Recovid/Controller/design/DESIGN.md

# Overview of Controller v2 specifications

## Use cases

Le RECOVID ne peut être utilisé que conjointement à un Oxymètre médical qui mesure, surveille et alerte le taux d'oxygénation du patient. Le Contrôleur est responsable d'assurer le cycle respiratoire (Insuffler, Relâcher) à une fréquence de 12 à 35 fois par minute H24 jusqu'à 14j d'affilées et d'alerter sur le moindre écart. L'IHM est nécessaire pour que le soignant analyse et ajuste les paramètres de la respiration (ce qui est tout de même moins critique).

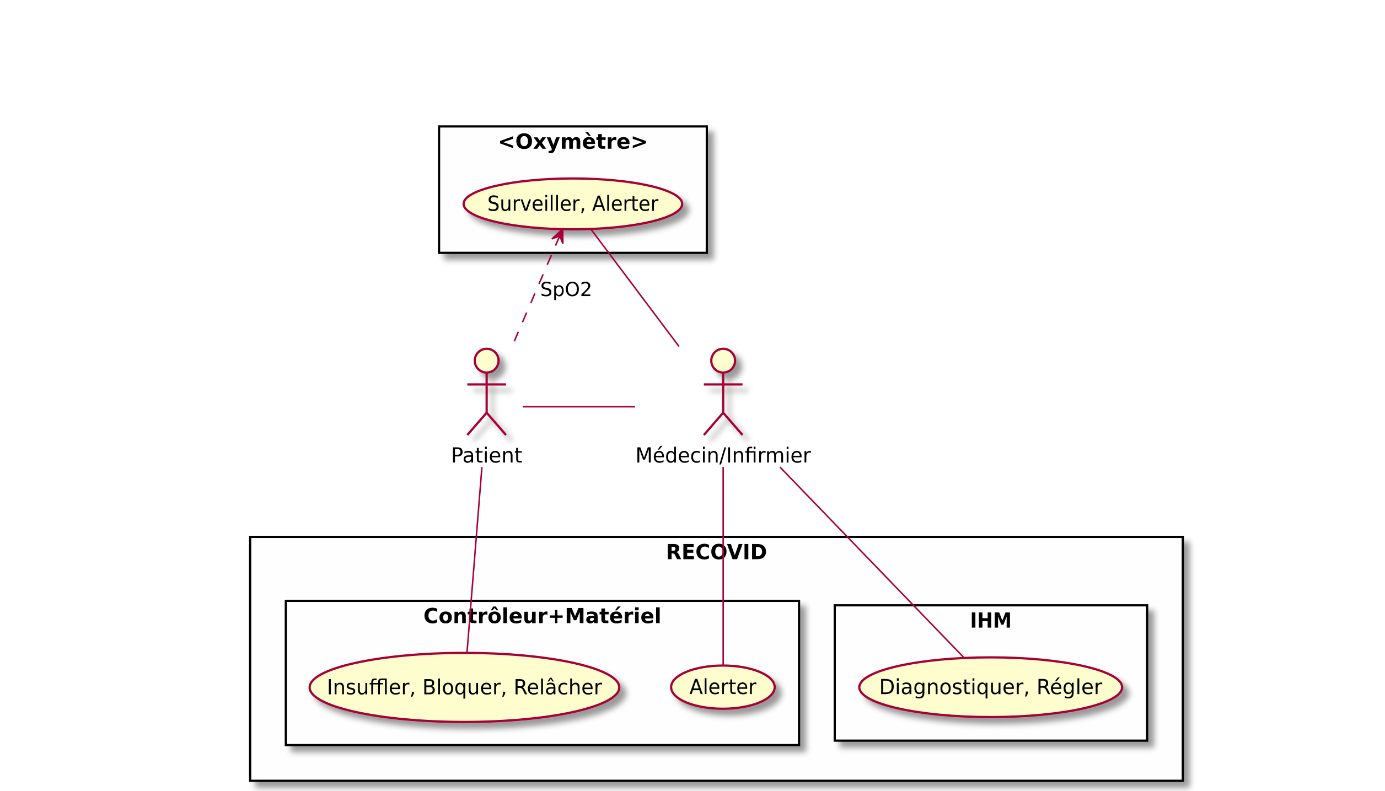
[picture p3: design/UseCases.png]


## Hardware

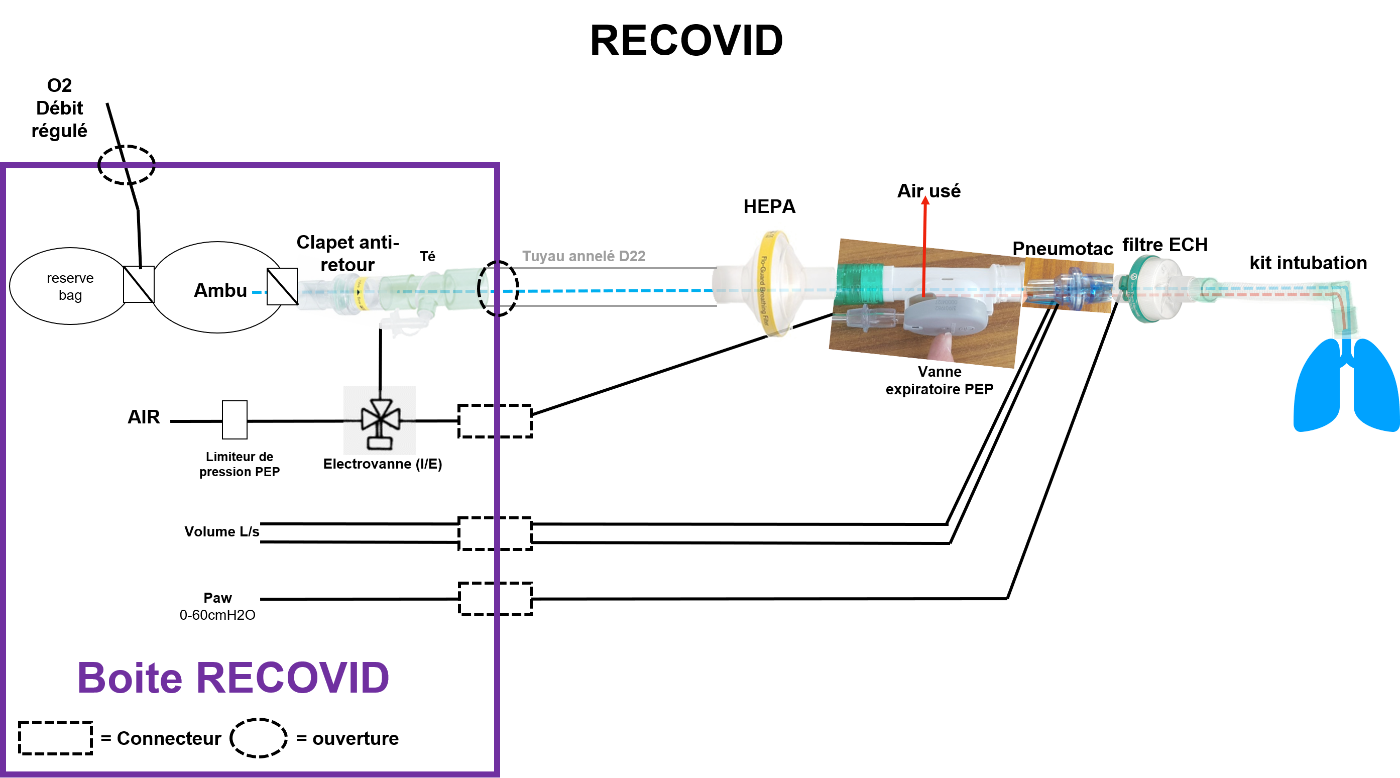
[picture p4: design/Schema_general_17avril.png]


## Information flow

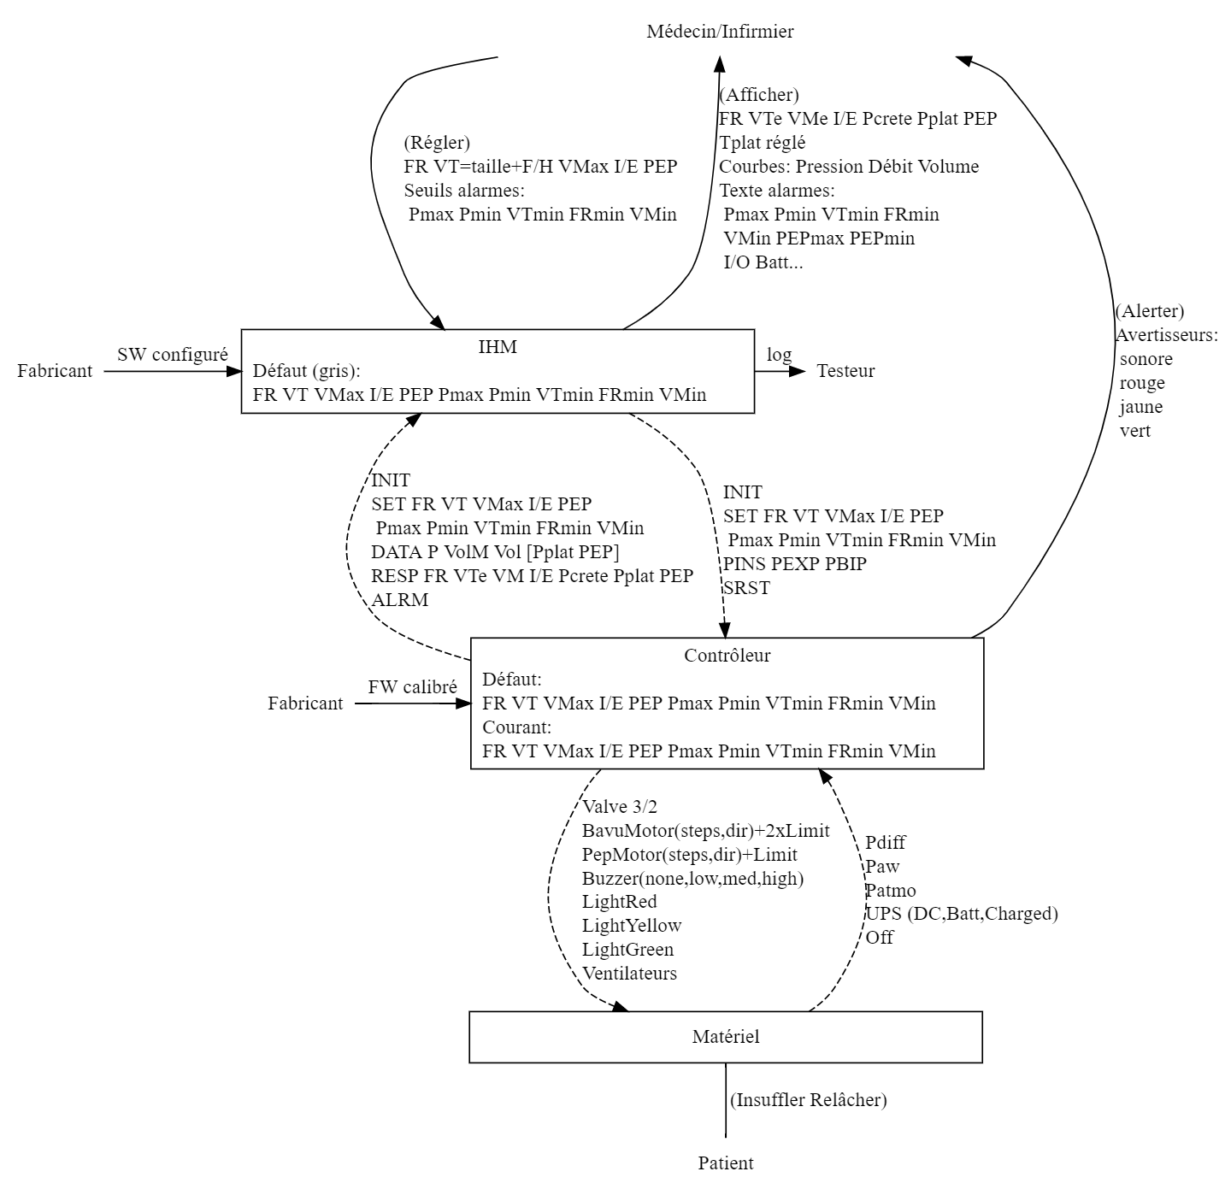
[picture p5: design/InformationFlow.png]


## State machines specifications

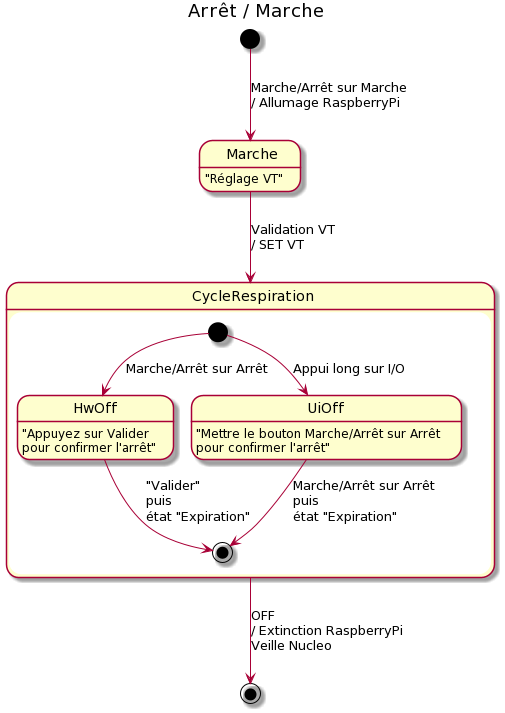
[picture p6: design/ArretMarche.png]


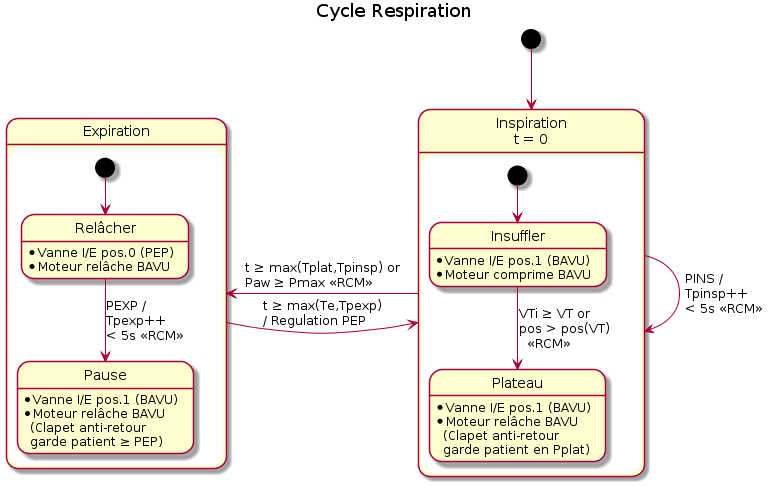
[picture p7: design/CycleRespiration+RCM.png]


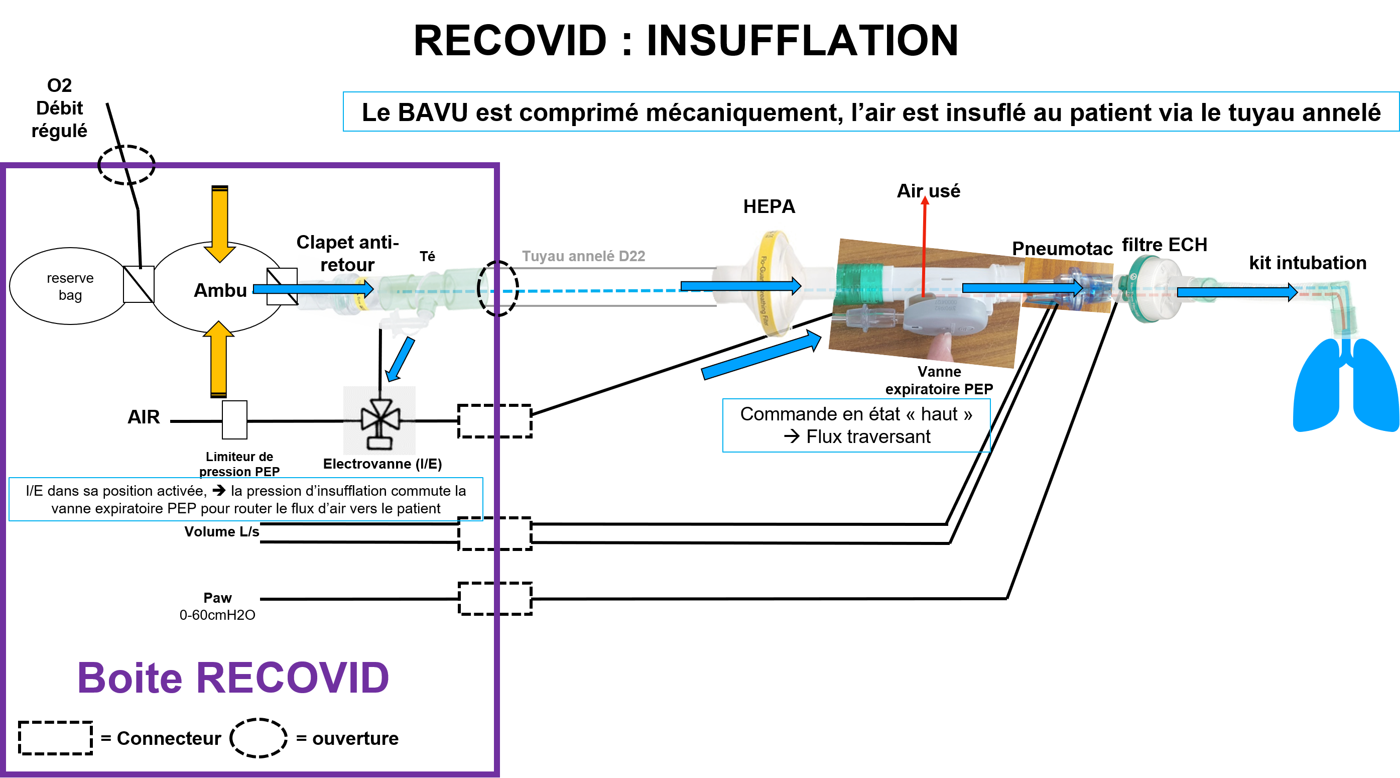
[picture p8: design/Schema_general_17avril_Insufflation.png]


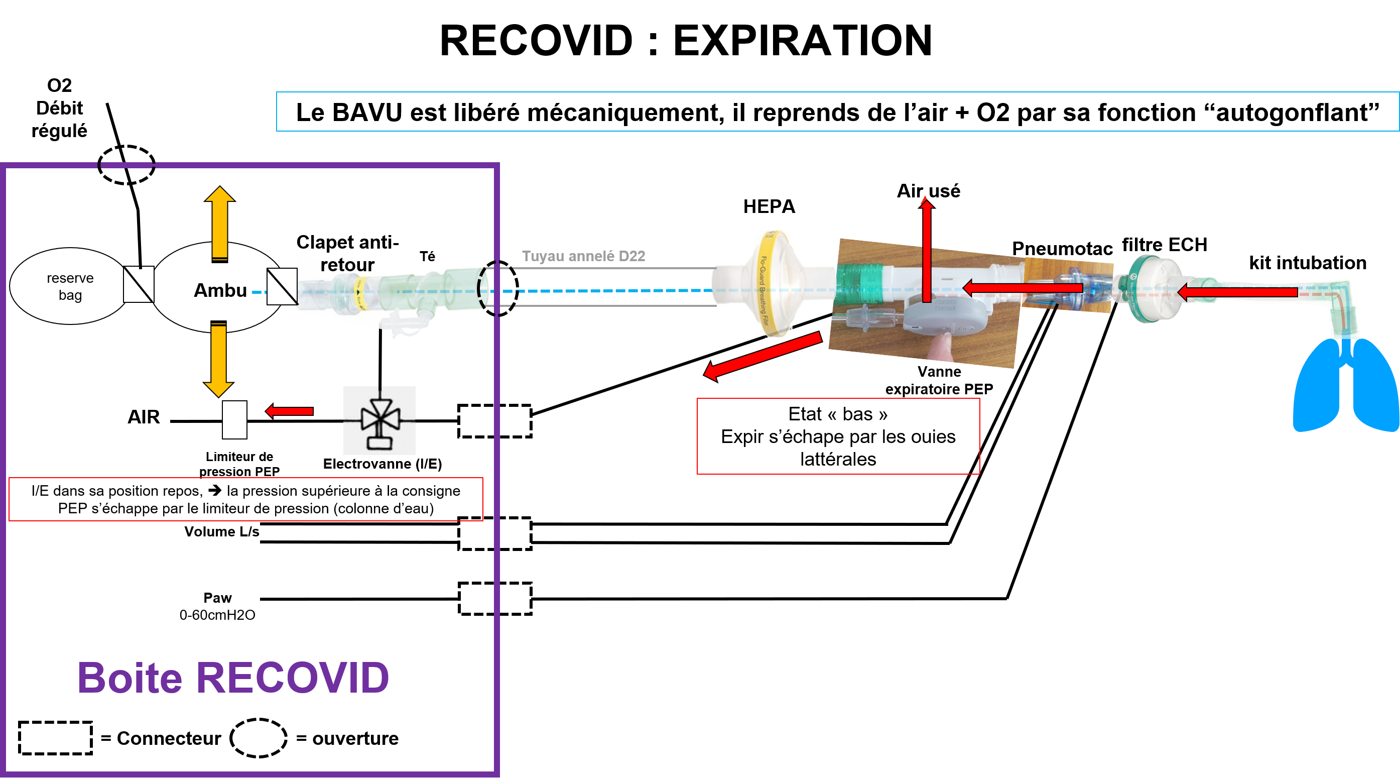
[picture p9: design/Schema_general_17avril_Expiration.png]


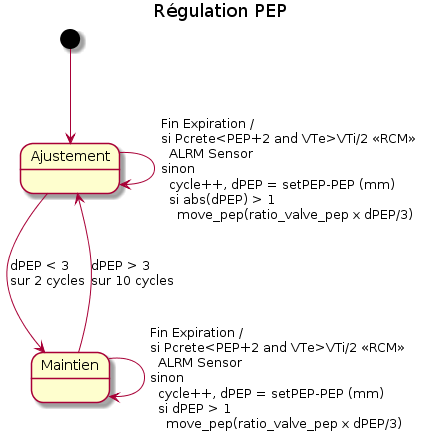
[picture p10: design/RegulationPEP.png]
