Recovid/Controller/(threads)

Thread 32 (2020-04-23):

Garantir un bon fonctionnement des conditions temporelles en cas de wrap-around

arnaud-clere, 2020-04-23:
Dans vos conditions temporelles de changement d'état (ou autres) il faut comparer des intervalles et non des temps absolus. Il faut aussi que vos temps soient comptés par des unsigned.
uint32_t t1=get_time_ms()
...
...
...
uint32_t t2=get_time_ms()

If ( t2 > t1 + zzz) peut retourner un résultat erroné s'il y a eu un rollover du timer

If ( t2-t1 > 800) retournera tjs un bon résultat (tant qu'il ny a pas eu 2 rollovers du timer)
Et comme la nucleo sera tjs alimentée (et pour le moment elle n'est pas mise en sommeil) , les risques de rollover ne sont pas à exclure

Thread 35 (2020-04-24):

Implémenter un mode arrêt à 2 confirmations (IHM + bouton physique)

arnaud-clere, 2020-04-24:
La state machine ci-dessous décrit le fonctionnement Marche/Arrêt qui encadre le CycleRespiration

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

Les événements et actions de cette state machine viennent soit de l'IHM soit du contrôleur.
Il faut faire évoluer l'IHM en utilisant le dialogue "Quitter" existant.
Il faut implémenter des fonctions sur le contrôleur pour :
* accepter une trame "OFF\tCS8:xx\n" de l'UI
* interroger la pin FS_ENABLED de la board revB (0 = bouton physique Marche/Arrêt sur Arrêt)
* couper l'alim du RaspberryPi
* mettre le Nucleo en low consumption (ThomasS va proposer qq chose)

arnaud-clere, 2020-04-27:
Voir branche on_off pour une ébauche (sans low_consumption ni extinction raspi ni reset settings)

Thread 36 (2020-04-24):

Implémenter une sauvegarde des paramètres de respiration sur mémoire Flash

arnaud-clere, 2020-04-24:
Il faut intégrer l'implémentation des deux fonctions déclarées dans https://github.com/Recovid/Controller/blob/c7a69c7313f047c11a9a81b572a026811d9f7104/C_Controller/lowlevel/include/lowlevel.h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
Dans le fichier :
https://github.com/Recovid/Controller/blob/master/C_Controller/lowlevel/stm32f303/flash.c

De sorte que le code de ihm_communication.c puisse lancer la sauvegarde *asynchrone* des paramètres validés. Cette fonction sera appelée en phase expiration pour ne pas perturber le driver moteur qui fonctionne en DMA.

Le fichier attaché implémente la fonction mais il faut encore l'intégrer.

De Hugo Van Reeth :
Le fichier à regarder est "Flash_save.c/h", dans lequel on trouve une fonction de Save et une fonction de Restore des paramètres. Il est plus simple d'écrire tous les paramètres d'un coup car il faut faire un erase de Flash avant écriture.

Quelques détails :
La structure de settings suivante n'existe pas dans le code (les paramètres individuels sont encapsulés dans ihm_communication.c) :
typedef struct __attribute__ ((aligned(4))){
    int version; // should always be first, since we use a pointer to this for union
    int setting_FR_pm;
    int setting_VT_mL;
    int setting_PEP_cmH2O;
    int setting_Vmax_Lpm;
    int setting_EoI_ratio;
    int setting_Pmax_cmH2O;
    int setting_Pmin_cmH2O;
    int setting_VTmin_mL;
    int setting_FRmin_pm;
    int setting_VMmin_Lm;
    int magic; // usefull to check that all settings were written until the end
    int crc; // should always be the last thing to write in Flash
} Settings_t;

J'ai donc rajouté par rapport aux settings de base
- en premier une Version
- à la fin un "magic" qui contient un int fixe qui permet de savoir au moins que tous les paramètres ont été écrit (double vérification avec le CRC qui peut tomber juste par hasard) (ca peut etre enlevé sur le CRC est robuste, ce qui n'est pas le cas dans mon exemple).
- puis un crc (j'ai fait un XOR de base, je ne sais pas ce que vous comptez utiliser comme type de CRC).
•	Les fonctions de lecture/écriture sont :
     int Save_Settings(Settings_t* settings, int pageAddress);
     int Restore_Settings(Settings_t* settings, int pageAddress);
Ces fonctions gèrent les erase de flash, les lecture/ecriture, et les calculs CRC. Il peut être intéressant de rajouter une vérification des valeurs des settings à postériori (si ils sont dans une fourchette cohérente, ...)
•	Pour les lectures/ecritures en Flash, plutot que de faire paramètre par paramètre, je copie directement le contenu mémoire de la structure complète en Flash sans me soucier du type de chaque setting. Avec cette mécanique, on peut rajouter/enlever des paramètres (de n'importe quel type int, float, char...) dans la structure sans avoir à retoucher les fonctions de lecture/ecriture Flash. C'est plus simple que d'écrire un par un les paramètres, qui pourraient avoir des types différents.
Par contre, il faut toujours que la version soit en premier dans la structure car je fais pointer mes pointeurs d'écriture dessus.
•	J'écris à la derniere page de la Flash (addresse 0x0807F800). J'ai modifié le .ld pour enlever cette page de la mémoire programme.
•	Le fichier main.c permet de tester ça :
-> Restore des paramètres au démarrage de la carte
-> Si appui court sur le bouton de la Nucleo => ecriture de données random dans la strcture, et sauvegarde en Flash
-> Si appui long (>1s) sur le bouton de la Nucleo => ecriture de valeurs par défaut dans la strcture, et sauvegarde en Flash

arnaud-clere, 2020-04-24:
[TEMPLATE_F303.zip](https://github.com/Recovid/Controller/files/4530333/TEMPLATE_F303.zip)

JulienDevillers, 2020-04-26:
Pour info, je ne crois pas que l'écriture en flash, influe sur le DMA. L'écriture en flash fige l'accès à la flash et donc empêche le code de continuer de s'exécuter (s'il est en flash, ce qui est généralement le cas) tant que l'écriture n'est pas terminée.

Sur le L0, L1, cela n'influe pas sur le DMA (voir AN4808 chapitre 2.2 _" Processes
independent from the core, such as DMA or peripherals may continue to work as long as
they avoid accessing the NVM bank."_ ).
Je pense que c'est pareil sur le F3. La sheet ne parle pas de stall du DMA pendant les fonctions de flash.

Si jamais ça aide.

Thread 37 (2020-04-24):

Simplifier la planification des différentes tâches pour plus de fiabilité ??!

arnaud-clere, 2020-04-24:
On a regroupé beaucoup de tâches FreeRTOS et il n'en reste que deux :
- La tâche "highlevel" qui gère le cycle respiratoire (1kHz)
- Une tâche qui gère la réception des messages de l'IHM
Cette dernière pourrait être appelée par cycle_respiration si et seulement si elle peut garantir de ne pas bloquer

A cette condition seulement, on pourrait n'avoir qu'une tâche high-level et une gestion du matériel par interrupt (I2C), moteur ballon (BAVU) via DMA+PWM, UART via DMA

Dans ce cas, on pourrait simplifier l'architecture en se passant de FreeRTOS pour, peut-être ??!, plus de maîtrise du code...

Closed 2020-04-28.

Thread 38 (2020-04-25):

Rendre la phase de relâchement du ballon (BAVU) plus fiable

arnaud-clere, 2020-04-25:
Le ballon est comprimé par une cordelette kevlar relativement rigide qui bien que tenue sur les poulies par des tours morts et des caches pourrait se détendre trop et s'enrouler provoquant une défaillance irrémédiable du cycle respiratoire (un arrêt et une remise en place par des personnes qualifiées étant nécessaire pour réparer le recovid). La commande de relâchement moteur semble actuellement trop brusque pour éliminer ce risque.

Aussi, en cas d'alarme Pmax, passer bursquement d'une commande moteur guidée par DMA+PWM à une commande relâchement (PWM constant ?) inverse à haute vitesse risque peut-être de mettre le moteur en difficulté (mode de défaillance ?)

L'idéal serait de toujours demander au moteur+mécanique de faire un cycle régulier, la sécurité patient étant en fait assurée exclusivement par l'éléctrovanne PEP (descente de pression en - de 200ms).

On peut déjà introduire une temporisation entre commandes press/release dans le cycle respiration, par ex. ne faire le release que dans Exhalation après 100ms.
Ensuite, on pourrait programmer un mouvement release en DMA avec une table de "step_t_us" avec accélération/décélération progressive.

arnaud-clere, 2020-04-27:
Pour Cyril, on ne pourra pas ne pas arrêter la compression du ballon dès le VTi observé atteint car ça risque de perturber le circuit pneumatique. Siméon discute avec ST pour avoir un arrêt propre du pilotage du mouvement de compression en DMA+PWM.

simson, 2020-04-30:
Fixed by bf218268cc2491dcad23ccb92acb369803d18d84

Closed 2020-04-30.

Thread 42 (2020-04-25):

Prévenir l'enroulement à contre-sens en cas de non-détection des limites "home 1 & 2"

arnaud-clere, 2020-04-25:
Le mouvement motor_release doit absolument être limité en cas de non-détection d'une des 2 limites "home 1" ou "home 2" car si une seule défaille, le moteur risque de dérouler toute la cordelette puis l'enrouler à contre sens avec une compression répétée du ballon (le moteur semble décrocher un temps puis repartir en compression).

Si on revient jusqu'à pos < -X steps il faut arrêter le mouvement et repartir à 0
NB1 : on a perdu des pas mais on pense que le BAVU est effectivement complètement relâché
NB2 : X ne doit pas dépasser le secteur angulaire de recouvrement de la cordelette (?)

arnaud-clere, 2020-05-06:
Il est possible de suivre un décompte théorique des pas envoyés en press qui fonctionne en DMA même si le mouvement est interrompu, mais ça demande un travail de mise au point directement sur le matériel. Il faudrait alors utiliser un mouvement DMA pour le release avec la même technique

Seulement après, on peut mettre une "butée soft" avec des actions a décider au niveau controller je pense (normalement on est en exiration donc voies aériennes patient au repos)...

si stepTheoric<-stepsSoftLimit :
    motor_stop() // a minima !
    _motor_lost = true
    // signaler le prb vie EventGroup FreeRTOS ?

Thread 44 (2020-04-25):

Timer de manière précise les acquisitions des capteurs I2C pression et flux

arnaud-clere, 2020-04-25:
Les données sont envoyées par les capteurs I2C (NPA et SDP) à leur rythme, à priori bien plus élevé que la fréquence théorique de 1kHz et 200Hz.

Il faut déterminer si les valeurs supplémentaires sont des doublons.

Si non, il faudrait d'une part pouvoir déterminer leur intervalle plus précisément qu'à la ms actuelle pour gagner en précision sur l'intégration du volume.

Et aussi les moyenner car il n'est pas évident qu'on puisse stocker beaucoup plus que les 200 échantillons actuels capturés à au moins 2ms d'intervalle pendant l'insufflation.

La branche freertos_periodic_timer peut être utilisée pour traiter ce problème en planifiant une tâche FreeRTOS à 1kHz. Par ailleurs, certaines branches de Controller-V1-F303 prennent un timer en µs en utilisant TIM_HandleTypeDef.

arnaud-clere, 2020-04-27:
intervalles sampling capteurs calculés par siméon avec timer µs : 4,8... pour Pdiff, 1,... pour Paw

JulienDevillers, 2020-04-27:
Après étude du fonctionnement des capteurs, nous avons conclu avec Siméon que le fonctionnement actuel est le plus efficace. Inclure tout de même la pull request que j'ai faite sur I2C.
Etant donné que le capteur ne signifie pas qu'il a de la donnée, le moyen d'avoir de la donnée fraîche est de l'interroger le plus souvent possible.

Closed 2020-04-27.

Thread 45 (2020-04-25):

Améliorer la gestion de Pmax

arnaud-clere, 2020-04-25:
Les spécifications vont être modifiées pour exclure la condition PEP+10 de Pmax. Il faudra reporter cette modification pour ne pas alerter le praticien sur un problème annexe à Pax>Pmax.

Par ailleurs, il faut modifier la condition Paw>Pmax dans cycle_respiration pour se baser sur Paw>80cmH2O (- imprécision de Paw) et être effective dans toutes les phases du cycle (comme une vanne de sécurité physique).

Thread 47 (2020-04-26):

Implémenter la correction de débit entre conditions atmosphériques standard et expiration patient

arnaud-clere, 2020-04-26:
QPatientBTPS = QPatientSLM * 1013/(Patmo-62,66) * (310°K/294°K)

Thread 48 (2020-04-26):

gestion uart stm32 <-> IHM

mbriday, 2020-04-26:
Si une trame de commande de l'ihm vers la carte stm32 n'est pas reçue complètement entre 2 jobs de la tâche de communication, alors la trame est ignorée.

Closed 2020-04-28.

Thread 52 (2020-04-28):

Eliminer les lib statiques du CMake pour la compilation sur cible

arnaud-clere, 2020-04-28:
Ces libs statiques font que le link n'est pas maitrisé (symboles en doubles, .c compilés avec de mauvais .h, etc.)

simson, 2020-04-30:
Done in 2792dca4008937666d51c504ffe048fd2217f7b9

Closed 2020-04-30.
