Recovid/Controller/sources/src/defaults.h

#ifndef __DEFAULTS_H__
#define __DEFAULTS_H__



#define DEFAULT_setting_FR_pm          (18) //!< \see set_setting_FR_pm to set it within the range defined by     VT, Vmax, EoI
#define DEFAULT_setting_VT_mL          (300)//!< \see set_setting_VT_mL to set it within the range defined by FR,     Vmax, EoI
#define DEFAULT_setting_Vmax_Lpm       (60) //!< \see set_setting_Vmax_Lpm to set it within the range defined by FR, VT,       EoI
#define DEFAULT_setting_EoI_ratio_x10  (20) //!< \see set_setting_EoI_ratio_x10 to set it within the range defined by FR, VT, Vmax

#define DEFAULT_setting_PEP_cmH2O      (5)

#define DEFAULT_setting_Pmax_cmH2O    (60)
#define DEFAULT_setting_Pmin_cmH2O    (20)
#define DEFAULT_setting_VTmin_mL      (150)
#define DEFAULT_setting_VTmax_mL      (1000)
#define DEFAULT_setting_FRmin_pm      (10)
#define DEFAULT_setting_VMmin_Lpm     (3)

#define DEFAULT_setting_PEPmax_cmH2O  (2)
#define DEFAULT_setting_PEPmin_cmH2O  (-2)

#define DEFAULT_Tpins_max_ms          (5000)
#define DEFAULT_Tpexp_max_ms          (5000)



#endif // __DEFAULTS_H__
