Recovid/Controller/sources/platforms/recovid_revB/motor.c

#include "recovid_revB.h"
#include "platform.h"
#include "platform_config.h"

static TIM_HandleTypeDef* _motor_tim = NULL;

static void period_elapsed_callback(TIM_HandleTypeDef *tim);

static volatile bool _moving;
static volatile bool _homing;
static volatile bool _home;
static volatile bool _limit_sw_A;
static volatile bool _limit_sw_B;
static volatile bool _active;

static void check_home() ;
void motor_enable(bool ena);

bool motor_release() {
  motor_stop();
  if( !_home) {
	  HAL_GPIO_WritePin(MOTOR_DIR_GPIO_Port, MOTOR_DIR_Pin, MOTOR_RELEASE_DIR);
	  _moving=true;
	  _homing=true;
    _motor_tim->Init.Period = MOTOR_RELEASE_STEP_US;
    HAL_TIM_Base_Init(_motor_tim);
	  HAL_TIM_PWM_Start(_motor_tim, MOTOR_TIM_CHANNEL);
  }
  return true;
}

bool motor_press(uint32_t* steps_profile_us, unsigned int nb_steps)
{   
    motor_stop();
    if (nb_steps > 0) {
        motor_enable(true);
        HAL_GPIO_WritePin(MOTOR_DIR_GPIO_Port, MOTOR_DIR_Pin, MOTOR_PRESS_DIR);
        _moving=true;
        _motor_tim->Init.Period = steps_profile_us[0];
        HAL_TIM_Base_Init(_motor_tim);
        HAL_DMA_Init(_motor_tim->hdma[TIM_DMA_ID_UPDATE]);
        HAL_TIM_PWM_Start_IT(_motor_tim, MOTOR_TIM_CHANNEL);
        HAL_TIM_DMABurst_MultiWriteStart(_motor_tim, TIM_DMABASE_ARR, TIM_DMA_UPDATE,	&steps_profile_us[1], TIM_DMABURSTLENGTH_1TRANSFER, nb_steps-1);
    }
    return true;
}

bool motor_stop() {
  if(_moving) {
    HAL_TIM_DMABurst_WriteStop(_motor_tim, TIM_DMA_ID_UPDATE);
    HAL_TIM_PWM_Stop(_motor_tim, MOTOR_TIM_CHANNEL);
    HAL_DMA_DeInit(_motor_tim->hdma[TIM_DMA_ID_UPDATE]);
    _moving=false;
	//dbg_print("MOTOR STOP\n");
  }
  return true;
}

bool is_motor_moving() {
  return _moving;
}

bool is_motor_home() {
  return _home;
}

bool is_motor_ok() {
  return _motor_tim!=NULL;
}

bool init_motor()
{
  if(_motor_tim==NULL) {
    _motor_tim= &motor_tim;
    // register IT callbacks
    HAL_TIM_RegisterCallback(_motor_tim, HAL_TIM_PERIOD_ELAPSED_CB_ID, period_elapsed_callback);

    _active= HAL_GPIO_ReadPin(MOTOR_ACTIVE_GPIO_Port, MOTOR_ACTIVE_Pin);

    _limit_sw_A= ! HAL_GPIO_ReadPin(MOTOR_LIMIT_SW_A_GPIO_Port, MOTOR_LIMIT_SW_A_Pin);
    _limit_sw_B= ! HAL_GPIO_ReadPin(MOTOR_LIMIT_SW_B_GPIO_Port, MOTOR_LIMIT_SW_B_Pin);
    check_home();
    HAL_TIM_Base_Start(_motor_tim);
    motor_enable(true);

    if(_home) {
      HAL_GPIO_WritePin(MOTOR_DIR_GPIO_Port, MOTOR_DIR_Pin, MOTOR_PRESS_DIR);
      _motor_tim->Init.Period = MOTOR_HOME_STEP_US;
      HAL_TIM_Base_Init(_motor_tim);
      _moving = true;
      _homing= false;
      HAL_TIM_PWM_Start(_motor_tim, MOTOR_TIM_CHANNEL);    
      while(_home);
      HAL_Delay(200);
      motor_stop();
      HAL_Delay(500);
    }
    _homing=true;
    _moving=true;
    HAL_GPIO_WritePin(MOTOR_DIR_GPIO_Port, MOTOR_DIR_Pin, MOTOR_RELEASE_DIR);
    _motor_tim->Init.Period = MOTOR_HOME_STEP_US;
    HAL_TIM_Base_Init(_motor_tim);
    HAL_TIM_PWM_Start(_motor_tim, MOTOR_TIM_CHANNEL);    
    while(!_home);
  }
  return true;
}

static void period_elapsed_callback(TIM_HandleTypeDef *tim)
{
  motor_stop();
}

void motor_limit_sw_A_irq() {
  static uint32_t last_time=0;
  uint32_t time= HAL_GetTick();
  if(time-last_time>10) {
    _limit_sw_A= ! HAL_GPIO_ReadPin(MOTOR_LIMIT_SW_A_GPIO_Port, MOTOR_LIMIT_SW_A_Pin);
	  _limit_sw_A ? light_yellow(On) : light_yellow(Off);
    check_home();
  }
  last_time=time;
}

void motor_limit_sw_B_irq() {  
  static uint32_t last_time=0;
  uint32_t time= HAL_GetTick();
  if(time-last_time>10) {
    _limit_sw_B= ! HAL_GPIO_ReadPin(MOTOR_LIMIT_SW_B_GPIO_Port, MOTOR_LIMIT_SW_B_Pin);
  	_limit_sw_B ? light_green(On) : light_green(Off);
    check_home();
  }
  last_time=time;
}

void motor_active_irq() {
  static uint32_t last_time=0;
  uint32_t time= HAL_GetTick();
  if(time-last_time>10) {
    _active=HAL_GPIO_ReadPin(MOTOR_ACTIVE_GPIO_Port, MOTOR_ACTIVE_Pin);
  }
  last_time=time;
}


static void check_home() {
  if(_limit_sw_A && _limit_sw_B) {
    _home=true;
    if(_homing) {
      motor_stop();
      _homing= false;
    }
  } else {
    _home=false;
  }
}

void motor_enable(bool ena) {
	HAL_GPIO_WritePin(MOTOR_ENA_GPIO_Port, MOTOR_ENA_Pin, ena?GPIO_PIN_SET:GPIO_PIN_RESET);
}
