Recovid/Controller/sources/platforms/recovid_revB/core/recovid_revB_hal_msp.c

/**
  ******************************************************************************
  * File Name          : bsp_hal_msp.c
  * Description        : This file provides code for the MSP Initialization 
  *                      and de-Initialization codes.
  ******************************************************************************
  * @attention
  *
  * <h2><center>&copy; Copyright (c) 2020 STMicroelectronics.
  * All rights reserved.</center></h2>
  *
  * This software component is licensed by ST under BSD 3-Clause license,
  * the "License"; You may not use this file except in compliance with the
  * License. You may obtain a copy of the License at:
  *                        opensource.org/licenses/BSD-3-Clause
  *
  ******************************************************************************
  */

/* Includes ------------------------------------------------------------------*/
#include "recovid_revB.h"

extern DMA_HandleTypeDef hdma_i2c1_rx;
extern DMA_HandleTypeDef hdma_i2c1_tx;

extern DMA_HandleTypeDef hdma_tim2_up;

extern DMA_HandleTypeDef hdma_tim3_ch4_up;

extern DMA_HandleTypeDef hdma_uart4_rx;

extern DMA_HandleTypeDef hdma_uart4_tx;

                        
void HAL_TIM_MspPostInit(TIM_HandleTypeDef *htim);
                                        /**
  * Initializes the Global MSP.
  */
void HAL_MspInit(void)
{

  __HAL_RCC_SYSCFG_CLK_ENABLE();
  __HAL_RCC_PWR_CLK_ENABLE();

  /* System interrupt init*/
  /* PendSV_IRQn interrupt configuration */
  HAL_NVIC_SetPriority(PendSV_IRQn, 15, 0);

}

/**
* @brief I2C MSP Initialization
* This function configures the hardware resources used in this example
* @param hi2c: I2C handle pointer
* @retval None
*/
void HAL_I2C_MspInit(I2C_HandleTypeDef* hi2c)
{
  GPIO_InitTypeDef GPIO_InitStruct = {0};
  if(hi2c->Instance==I2C1)
  {
  
    __HAL_RCC_GPIOB_CLK_ENABLE();
    /**I2C1 GPIO Configuration    
    PB8     ------> I2C1_SCL
    PB9     ------> I2C1_SDA 
    */
    GPIO_InitStruct.Pin = SENSOR_SCL_Pin|SENSOR_SDA_Pin;
    GPIO_InitStruct.Mode = GPIO_MODE_AF_OD;
    GPIO_InitStruct.Pull = GPIO_PULLUP;
    GPIO_InitStruct.Speed = GPIO_SPEED_FREQ_HIGH;
    GPIO_InitStruct.Alternate = GPIO_AF4_I2C1;
    HAL_GPIO_Init(GPIOB, &GPIO_InitStruct);

    /* Peripheral clock enable */
    __HAL_RCC_I2C1_CLK_ENABLE();
  
    /* I2C1 DMA Init */
    /* I2C1_RX Init */
    hdma_i2c1_rx.Instance = DMA1_Channel7;
    hdma_i2c1_rx.Init.Direction = DMA_PERIPH_TO_MEMORY;
    hdma_i2c1_rx.Init.PeriphInc = DMA_PINC_DISABLE;
    hdma_i2c1_rx.Init.MemInc = DMA_MINC_ENABLE;
    hdma_i2c1_rx.Init.PeriphDataAlignment = DMA_PDATAALIGN_BYTE;
    hdma_i2c1_rx.Init.MemDataAlignment = DMA_MDATAALIGN_BYTE;
    hdma_i2c1_rx.Init.Mode = DMA_NORMAL;
    hdma_i2c1_rx.Init.Priority = DMA_PRIORITY_LOW;
    if (HAL_DMA_Init(&hdma_i2c1_rx) != HAL_OK)
    {
      Error_Handler();
    }

    __HAL_LINKDMA(hi2c,hdmarx,hdma_i2c1_rx);


	/* I2C1 DMA Init */
    /* I2C1_TX Init */
    hdma_i2c1_tx.Instance = DMA1_Channel6;
    hdma_i2c1_tx.Init.Direction = DMA_PERIPH_TO_MEMORY;
    hdma_i2c1_tx.Init.PeriphInc = DMA_PINC_DISABLE;
    hdma_i2c1_tx.Init.MemInc = DMA_MINC_ENABLE;
    hdma_i2c1_tx.Init.PeriphDataAlignment = DMA_PDATAALIGN_BYTE;
    hdma_i2c1_tx.Init.MemDataAlignment = DMA_MDATAALIGN_BYTE;
    hdma_i2c1_tx.Init.Mode = DMA_NORMAL;
    hdma_i2c1_tx.Init.Priority = DMA_PRIORITY_LOW;
    if (HAL_DMA_Init(&hdma_i2c1_tx) != HAL_OK)
    {
      Error_Handler();
    }

    __HAL_LINKDMA(hi2c,hdmatx,hdma_i2c1_tx);

    /* I2C1 interrupt Init */
    HAL_NVIC_SetPriority(I2C1_EV_IRQn, 5, SENSORS_I2C_EV_IRQ_PRIORITY);
    HAL_NVIC_EnableIRQ(I2C1_EV_IRQn);
    HAL_NVIC_SetPriority(I2C1_ER_IRQn, 5, SENSORS_I2C_ER_IRQ_PRIORITY);
    HAL_NVIC_EnableIRQ(I2C1_ER_IRQn);
  }

}

/**
* @brief I2C MSP De-Initialization
* This function freeze the hardware resources used in this example
* @param hi2c: I2C handle pointer
* @retval None
*/
void HAL_I2C_MspDeInit(I2C_HandleTypeDef* hi2c)
{
  if(hi2c->Instance==I2C1)
  {
    /* Peripheral clock disable */
    __HAL_RCC_I2C1_CLK_DISABLE();
  
    /**I2C1 GPIO Configuration    
    PB8     ------> I2C1_SCL
    PB9     ------> I2C1_SDA 
    */
    HAL_GPIO_DeInit(GPIOB, SENSOR_SCL_Pin|SENSOR_SDA_Pin);

    /* I2C1 DMA DeInit */
    HAL_DMA_DeInit(hi2c->hdmarx);

    /* I2C1 interrupt DeInit */
    HAL_NVIC_DisableIRQ(I2C1_EV_IRQn);
    HAL_NVIC_DisableIRQ(I2C1_ER_IRQn);
  }

}

/**
* @brief TIM_Base MSP Initialization
* This function configures the hardware resources used in this example
* @param htim_base: TIM_Base handle pointer
* @retval None
*/
void HAL_TIM_Base_MspInit(TIM_HandleTypeDef* htim_base)
{
  if(htim_base->Instance==TIM2)
  {
    /* Peripheral clock enable */
    __HAL_RCC_TIM2_CLK_ENABLE();
  
    /* TIM2 DMA Init */
    /* TIM2_UP Init */
    hdma_tim2_up.Instance = DMA1_Channel2;
    hdma_tim2_up.Init.Direction = DMA_MEMORY_TO_PERIPH;
    hdma_tim2_up.Init.PeriphInc = DMA_PINC_DISABLE;
    hdma_tim2_up.Init.MemInc = DMA_MINC_ENABLE;
    hdma_tim2_up.Init.PeriphDataAlignment = DMA_PDATAALIGN_WORD;
    hdma_tim2_up.Init.MemDataAlignment = DMA_MDATAALIGN_WORD;
    hdma_tim2_up.Init.Mode = DMA_NORMAL;
    hdma_tim2_up.Init.Priority = DMA_PRIORITY_HIGH;
    if (HAL_DMA_Init(&hdma_tim2_up) != HAL_OK)
    {
      Error_Handler();
    }

    __HAL_LINKDMA(htim_base,hdma[TIM_DMA_ID_UPDATE],hdma_tim2_up);

    /* TIM2 interrupt Init */
    HAL_NVIC_SetPriority(TIM2_IRQn, 5, MOTOR_TIM_IRQ_PRIORITY);
    HAL_NVIC_EnableIRQ(TIM2_IRQn);
  }
  else if(htim_base->Instance==TIM3)
  {
    /* Peripheral clock enable */
    __HAL_RCC_TIM3_CLK_ENABLE();
  
    /* TIM3 DMA Init */
    /* TIM3_CH4_UP Init */
    hdma_tim3_ch4_up.Instance = DMA1_Channel3;
    hdma_tim3_ch4_up.Init.Direction = DMA_PERIPH_TO_MEMORY;
    hdma_tim3_ch4_up.Init.PeriphInc = DMA_PINC_DISABLE;
    hdma_tim3_ch4_up.Init.MemInc = DMA_MINC_ENABLE;
    hdma_tim3_ch4_up.Init.PeriphDataAlignment = DMA_PDATAALIGN_HALFWORD;
    hdma_tim3_ch4_up.Init.MemDataAlignment = DMA_MDATAALIGN_HALFWORD;
    hdma_tim3_ch4_up.Init.Mode = DMA_NORMAL;
    hdma_tim3_ch4_up.Init.Priority = DMA_PRIORITY_LOW;
    if (HAL_DMA_Init(&hdma_tim3_ch4_up) != HAL_OK)
    {
      Error_Handler();
    }

    /* Several peripheral DMA handle pointers point to the same DMA handle.
     Be aware that there is only one channel to perform all the requested DMAs. */
    __HAL_LINKDMA(htim_base,hdma[TIM_DMA_ID_CC4],hdma_tim3_ch4_up);
    __HAL_LINKDMA(htim_base,hdma[TIM_DMA_ID_UPDATE],hdma_tim3_ch4_up);

    /* TIM3 interrupt Init */
    HAL_NVIC_SetPriority(TIM3_IRQn, 5, PEP_TIM_IRQ_PRIORITY);
    HAL_NVIC_EnableIRQ(TIM3_IRQn);

  } else if(htim_base->Instance==TIM7)
  {
    /* Peripheral clock enable */
    __HAL_RCC_TIM7_CLK_ENABLE();
  }


}

void HAL_TIM_MspPostInit(TIM_HandleTypeDef* htim)
{
  GPIO_InitTypeDef GPIO_InitStruct = {0};
  if(htim->Instance==TIM2)
  {
    __HAL_RCC_GPIOA_CLK_ENABLE();
    /**TIM2 GPIO Configuration    
    PA15     ------> TIM2_CH1 
    */
    GPIO_InitStruct.Pin = MOTOR_STEP_Pin;
    GPIO_InitStruct.Mode = GPIO_MODE_AF_PP;
    GPIO_InitStruct.Pull = GPIO_NOPULL;
    GPIO_InitStruct.Speed = GPIO_SPEED_FREQ_LOW;
    GPIO_InitStruct.Alternate = GPIO_AF1_TIM2;
    HAL_GPIO_Init(MOTOR_STEP_GPIO_Port, &GPIO_InitStruct);

  }
  else if(htim->Instance==TIM3)
  {
  
    __HAL_RCC_GPIOC_CLK_ENABLE();
    /**TIM3 GPIO Configuration    
    PC9     ------> TIM3_CH4 
    */
    GPIO_InitStruct.Pin = PEP_STEP_Pin;
    GPIO_InitStruct.Mode = GPIO_MODE_AF_PP;
    GPIO_InitStruct.Pull = GPIO_NOPULL;
    GPIO_InitStruct.Speed = GPIO_SPEED_FREQ_LOW;
    GPIO_InitStruct.Alternate = GPIO_AF2_TIM3;
    HAL_GPIO_Init(PEP_STEP_GPIO_Port, &GPIO_InitStruct);

  }

}
/**
* @brief TIM_Base MSP De-Initialization
* This function freeze the hardware resources used in this example
* @param htim_base: TIM_Base handle pointer
* @retval None
*/
void HAL_TIM_Base_MspDeInit(TIM_HandleTypeDef* htim_base)
{
  if(htim_base->Instance==TIM2)
  {
    /* Peripheral clock disable */
    __HAL_RCC_TIM2_CLK_DISABLE();

    /* TIM2 DMA DeInit */
    HAL_DMA_DeInit(htim_base->hdma[TIM_DMA_ID_UPDATE]);

    /* TIM2 interrupt DeInit */
    HAL_NVIC_DisableIRQ(TIM2_IRQn);
  }
  else if(htim_base->Instance==TIM3)
  {
    /* Peripheral clock disable */
    __HAL_RCC_TIM3_CLK_DISABLE();

    /* TIM3 DMA DeInit */
    HAL_DMA_DeInit(htim_base->hdma[TIM_DMA_ID_CC4]);
    HAL_DMA_DeInit(htim_base->hdma[TIM_DMA_ID_UPDATE]);

    /* TIM3 interrupt DeInit */
    HAL_NVIC_DisableIRQ(TIM3_IRQn);
  }

}

/**
* @brief UART MSP Initialization
* This function configures the hardware resources used in this example
* @param huart: UART handle pointer
* @retval None
*/
void HAL_UART_MspInit(UART_HandleTypeDef* huart)
{
  GPIO_InitTypeDef GPIO_InitStruct = {0};
  if(huart->Instance==UART4)
  {
    /* Peripheral clock enable */
    __HAL_RCC_UART4_CLK_ENABLE();
  
    __HAL_RCC_GPIOC_CLK_ENABLE();
    /**UART4 GPIO Configuration    
    PC10     ------> UART4_TX
    PC11     ------> UART4_RX 
    */
    GPIO_InitStruct.Pin = HMI_TX_Pin|HMI_RX_Pin;
    GPIO_InitStruct.Mode = GPIO_MODE_AF_PP;
    GPIO_InitStruct.Pull = GPIO_NOPULL;
    GPIO_InitStruct.Speed = GPIO_SPEED_FREQ_HIGH;
    GPIO_InitStruct.Alternate = GPIO_AF5_UART4;
    HAL_GPIO_Init(GPIOC, &GPIO_InitStruct);

    /* UART4 DMA Init */
    /* UART4_RX Init */
    hdma_uart4_rx.Instance = DMA2_Channel3;
    hdma_uart4_rx.Init.Direction = DMA_PERIPH_TO_MEMORY;
    hdma_uart4_rx.Init.PeriphInc = DMA_PINC_DISABLE;
    hdma_uart4_rx.Init.MemInc = DMA_MINC_ENABLE;
    hdma_uart4_rx.Init.PeriphDataAlignment = DMA_PDATAALIGN_BYTE;
    hdma_uart4_rx.Init.MemDataAlignment = DMA_MDATAALIGN_BYTE;
    hdma_uart4_rx.Init.Mode = DMA_CIRCULAR;
    hdma_uart4_rx.Init.Priority = DMA_PRIORITY_HIGH;
    if (HAL_DMA_Init(&hdma_uart4_rx) != HAL_OK)
    {
      Error_Handler();
    }

    __HAL_LINKDMA(huart,hdmarx,hdma_uart4_rx);

    /* UART4_TX Init */
    hdma_uart4_tx.Instance = DMA2_Channel5;
    hdma_uart4_tx.Init.Direction = DMA_MEMORY_TO_PERIPH;
    hdma_uart4_tx.Init.PeriphInc = DMA_PINC_DISABLE;
    hdma_uart4_tx.Init.MemInc = DMA_MINC_ENABLE;
    hdma_uart4_tx.Init.PeriphDataAlignment = DMA_PDATAALIGN_BYTE;
    hdma_uart4_tx.Init.MemDataAlignment = DMA_MDATAALIGN_BYTE;
    hdma_uart4_tx.Init.Mode = DMA_NORMAL;
    hdma_uart4_tx.Init.Priority = DMA_PRIORITY_LOW;
    if (HAL_DMA_Init(&hdma_uart4_tx) != HAL_OK)
    {
      Error_Handler();
    }

    __HAL_LINKDMA(huart,hdmatx,hdma_uart4_tx);

    /* UART4 interrupt Init */
    HAL_NVIC_SetPriority(HMI_UART_IRQn, 5, HMI_UART_IRQ_PRIORITY);              
  }
  else if(huart->Instance==USART2)
  {
    /* Peripheral clock enable */
    __HAL_RCC_USART2_CLK_ENABLE();
    __HAL_RCC_GPIOA_CLK_ENABLE();
    /**USART2 GPIO Configuration    
    PA2     ------> USART2_TX
    PA3     ------> USART2_RX 
    */
    GPIO_InitStruct.Pin = DBG_TX_Pin|DBG_RX_Pin;
    GPIO_InitStruct.Mode = GPIO_MODE_AF_PP;
    GPIO_InitStruct.Pull = GPIO_NOPULL;
    GPIO_InitStruct.Speed = GPIO_SPEED_FREQ_LOW;
    GPIO_InitStruct.Alternate = GPIO_AF7_USART2;
    HAL_GPIO_Init(GPIOA, &GPIO_InitStruct);

    /* USART2 interrupt Init */
    HAL_NVIC_SetPriority(DBG_UART_IRQn, 5, 0);
    HAL_NVIC_EnableIRQ(DBG_UART_IRQn);
  }

}

/**
* @brief UART MSP De-Initialization
* This function freeze the hardware resources used in this example
* @param huart: UART handle pointer
* @retval None
*/
void HAL_UART_MspDeInit(UART_HandleTypeDef* huart)
{
  if(huart->Instance==UART4)
  {
    /* Peripheral clock disable */
    __HAL_RCC_UART4_CLK_DISABLE();
  
    /**UART4 GPIO Configuration    
    PC10     ------> UART4_TX
    PC11     ------> UART4_RX 
    */
    HAL_GPIO_DeInit(GPIOC, GPIO_PIN_10|GPIO_PIN_11);

    /* UART4 DMA DeInit */
    HAL_DMA_DeInit(huart->hdmarx);
    HAL_DMA_DeInit(huart->hdmatx);

    /* UART4 interrupt DeInit */
    HAL_NVIC_DisableIRQ(UART4_IRQn);
  }
  else if(huart->Instance==USART2)
  {
    /* Peripheral clock disable */
    __HAL_RCC_USART2_CLK_DISABLE();
  
    /**USART2 GPIO Configuration    
    PA2     ------> USART2_TX
    PA3     ------> USART2_RX 
    */
    HAL_GPIO_DeInit(GPIOA, DBG_TX_Pin|DBG_RX_Pin);

    /* USART2 interrupt DeInit */
    HAL_NVIC_DisableIRQ(USART2_IRQn);
  }

}


/************************ (C) COPYRIGHT STMicroelectronics *****END OF FILE****/
