Recovid/Controller/sources/platforms/recovid_revB/core/recovid_revB_hal_msp_tick.c

/**
  ******************************************************************************
  * @file    bsp_hal_timebase_TIM.c 
  * @brief   HAL time base based on the hardware TIM.
  ******************************************************************************
  * @attention
  *
  * <h2><center>&copy; Copyright (c) 2020 STMicroelectronics.
  * All rights reserved.</center></h2>
  *
  * This software component is licensed by ST under BSD 3-Clause license,
  * the "License"; You may not use this file except in compliance with the
  * License. You may obtain a copy of the License at:
  *                        opensource.org/licenses/BSD-3-Clause
  *
  ******************************************************************************
  */

/* Includes ------------------------------------------------------------------*/
#include "stm32f3xx_hal.h"
 
TIM_HandleTypeDef        htim16; 
void hal_tick_period_ellapsed_callback(TIM_HandleTypeDef* htim);

/**
  * @brief  This function configures the TIM16 as a time base source. 
  *         The time source is configured  to have 1ms time base with a dedicated 
  *         Tick interrupt priority. 
  * @note   This function is called  automatically at the beginning of program after
  *         reset by HAL_Init() or at any time when clock is configured, by HAL_RCC_ClockConfig(). 
  * @param  TickPriority: Tick interrupt priority.
  * @retval HAL status
  */
HAL_StatusTypeDef HAL_InitTick(uint32_t TickPriority)
{
  RCC_ClkInitTypeDef    clkconfig;
  uint32_t              uwTimclock = 0;
  uint32_t              uwPrescalerValue = 0;
  uint32_t              pFLatency;
  
  /*Configure the TIM16 IRQ priority */
  HAL_NVIC_SetPriority(TIM1_UP_TIM16_IRQn, TickPriority ,0); 
  
  /* Enable the TIM16 global Interrupt */
  HAL_NVIC_EnableIRQ(TIM1_UP_TIM16_IRQn); 
  
  /* Enable TIM16 clock */
  __HAL_RCC_TIM16_CLK_ENABLE();
  
  /* Get clock configuration */
  HAL_RCC_GetClockConfig(&clkconfig, &pFLatency);
  
  /* Compute TIM16 clock */
  uwTimclock = HAL_RCC_GetPCLK2Freq();
   
  /* Compute the prescaler value to have TIM16 counter clock equal to 1MHz */
  uwPrescalerValue = (uint32_t) ((uwTimclock / 1000000) - 1);
  
  /* Initialize TIM16 */
  htim16.Instance = TIM16;
  
  /* Initialize TIMx peripheral as follow:
  + Period = [(TIM16CLK/1000) - 1]. to have a (1/1000) s time base.
  + Prescaler = (uwTimclock/1000000 - 1) to have a 1MHz counter clock.
  + ClockDivision = 0
  + Counter direction = Up
  */
  htim16.Init.Period = (1000000 / 1000) - 1;
  htim16.Init.Prescaler = uwPrescalerValue;
  htim16.Init.ClockDivision = 0;
  htim16.Init.CounterMode = TIM_COUNTERMODE_UP;
  if(HAL_TIM_Base_Init(&htim16) != HAL_OK ||
    HAL_TIM_RegisterCallback(&htim16, HAL_TIM_PERIOD_ELAPSED_CB_ID, hal_tick_period_ellapsed_callback))
  {    
    return HAL_ERROR;  
  }
  
  /* Start the TIM time Base generation in interrupt mode */
  return HAL_TIM_Base_Start_IT(&htim16);
}

/**
  * @brief  Suspend Tick increment.
  * @note   Disable the tick increment by disabling TIM16 update interrupt.
  * @param  None
  * @retval None
  */
void HAL_SuspendTick(void)
{
  /* Disable TIM16 update Interrupt */
  __HAL_TIM_DISABLE_IT(&htim16, TIM_IT_UPDATE);                                                  
}

/**
  * @brief  Resume Tick increment.
  * @note   Enable the tick increment by Enabling TIM16 update interrupt.
  * @param  None
  * @retval None
  */
void HAL_ResumeTick(void)
{
  /* Enable TIM16 Update interrupt */
  __HAL_TIM_ENABLE_IT(&htim16, TIM_IT_UPDATE);
}

void hal_tick_period_ellapsed_callback(TIM_HandleTypeDef* htim) {
  HAL_IncTick();
}


void TIM1_UP_TIM16_IRQHandler(void)
{
	  HAL_TIM_IRQHandler(&htim16);
}


/************************ (C) COPYRIGHT STMicroelectronics *****END OF FILE****/
