Recovid/Controller/sources/src/template.c

#include "common.h"
#include "config.h"
#include "template.h"

// Other dependencies


//----------------------------------------------------------
// Private defines
//----------------------------------------------------------

//----------------------------------------------------------
// Private typedefs
//----------------------------------------------------------

//----------------------------------------------------------
// Private variables
//----------------------------------------------------------

//----------------------------------------------------------
// Private functions prototypes
//----------------------------------------------------------

//----------------------------------------------------------
// Public variables
//----------------------------------------------------------

//----------------------------------------------------------
// Public functions
//----------------------------------------------------------

//----------------------------------------------------------
// Private functions
//----------------------------------------------------------
