Recovid/Controller/sources/platforms/simu/flash.c

#include <stdint.h>
#include <stdbool.h>

uint16_t read_saved_value(uint16_t idx)
{
    return 0; // TODO read from cached file ?
}

bool save_value_async(uint16_t index, uint16_t value)
{
    return false; // TODO save all to file ?
}
