Recovid/Controller/sources/platforms/simu/vassertcall.c

#include <stdio.h>
#include <stdlib.h>

#include "FreeRTOS.h"
#include "task.h"

void vAssertCalled( unsigned long ulLine, const char * const pcFileName )
{
    taskENTER_CRITICAL();
    {
        printf("[ASSERT] %s:%lu\n", pcFileName, ulLine);
        fflush(stdout);
    }
    taskEXIT_CRITICAL();
    exit(-1);
}
