Recovid/Controller/(commit log)

2020-03-27 add sensor references
2020-03-29 add remark about airflow sensor in readme
2020-03-30 Add Thread library
2020-04-01 sensors test code
2020-04-01 embedded code for sensor tests
2020-04-01 add sensor python code
2020-04-05 Added PINS, PEXP, PBIP and a new SRST (soft reset) Added forever loop blocking every 5sec for manual interactions Added 1kHz loop for controller: sense_and_compute & cycle_respiration tasks Added 40H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
    [controller.c, controller.h, main.c]
2020-04-06 WIP (builds and run but does not 'live') More complete hardware interface and simulation (PEP motor missing) Basic cycle_respiration() Elaborate sensor simulation based on BAVU and lung model
    [controller.c, main.c]
2020-04-06 Added self_tests and fixed some bugs
    [controller.c, controller.h, main.c]
2020-04-06 Changed send_DATA and send_RESP to use float to avoid problems with unchecked casts to int. Fixes a few issues Still not good repiratory cycle data
    [controller.c, main.c]
2020-04-07 Added more 'modules' to split work
    [configuration.h]
2020-04-07 Cmake version
    To build for native target cmake -DTARGET=native; make
    To build for stm32 target cmake -DTARGET=stm32f303; make
    Stm32 is the defualt target but the choosen target stay in cache
2020-04-07 Intégration de la com à la stm32, non testé
2020-04-08 Fix msitake between PEP_cmH2O and Pexp_cmH2O
    PEP_cmH2O is the setting for exhalation pressure
    Pexp_cmH2O is the value read during the exhalation
    [controller.c]
2020-04-08 controller.c: fix msiconversion L to mL
    [controller.c]
2020-04-08 controler.c: use read value instead of reading the sensors and change state after send RESP
2020-04-08 first P(ID) version of flow feedback loop
2020-04-08 add working stm32 uart implementation: - add dequeue module in /tool - add LL drivers for the RX_IDLE Line IRQ
2020-04-09 Merge with Arnaud readonly settings
    WARNING: Moved settings to read-only functions in ihm_communication.h to
    avoid dangerous confusion between settings and read/computed values
    TODO: cycle_respiration is broken (no more RESP)
    Added some hw interfaces
    [controller.c, controller.h, main.c]
2020-04-09 native/hardware_simulation.c: Fix Q simulation during transition Ins->Plat
    The flow was wrongly calculated based on the zero during Plat
    We store the last non zero value and start at it during Exhal
2020-04-09 TaskSensing.c: read the sensors, cotroller uses accesors now
2020-04-10 Attempt to fix simulator on STM32
    [vassertcall.c]
2020-04-10 Fixed warnings including extra and pedantic ones
    [controller.c]
2020-04-11 Included "platform.h" first in various headers to complement std headers and possibly introduce global compile settings Used more precise integer types (unsigned 16/32) Used float get_setting_* to av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
    [controller.c]
2020-04-11 Added basic unit-test framework Added debug macros to platform.h
2020-04-11 Fixed default setting values Added some comments to lowlevel.h
    [platform.h]
2020-04-11 add full speed Paw pressure and Non HoldMaster i2c mode for sdp610
2020-04-11 Fix compiler warnings, missing return
    [controller.c, main.c]
2020-04-11 Fix communication frames
    VMAX_ => "FLOW_"
    no sign for Pcrete
2020-04-11 Add unit test : blink led onboard
2020-04-11 Add LEDs implem for native
2020-04-11 fixup! Add LEDs implem for native
2020-04-12 Add flow plateau slope and mean P(ID)
2020-04-12 Regroup leds and buzzer
    [controller.c, lowlevel_simulation.c, simple_indicators.c]
2020-04-12 fixup! Regroup leds and buzzer
2020-04-13 refactor pid variables
2020-04-13 Fixed build broken by recursive include of native/simple_indicators.h that actually contained simple_indicators.c code Replace TESTS with NTESTS to build lowlevel unit-tests Fixed EXE_EXT for win32
    [lowlevel_simulation.c]
2020-04-14 moved unit_tests to tests/main.c (and blink() to simple_indicators.*)
    [configuration.h]
2020-04-14 Final lowlevel.h interface from high-level controller to low-level drivers
    [configuration.h]
2020-04-14 More meaningful Pdiff simulation and tests
    [configuration.h]
2020-04-15 lowlevel: simple_indicators: use the correct pin for F303RE
    [simple_indicators.c]
2020-04-15 lowlevel: i2c: read on sensors using IT
    The I2C sensors are tested to be presents at init.
    You should see a :
    - 1 blink for the SDP610-500Pa
    - 1 for the HSCMRNN160MG6A3
    - 1 for the BMP280
2020-04-15 UART: Allow to change UART (USAR2 vs USART4)
    Using the define RASPI
2020-04-15 STM32cube genrated file cleanup
2020-04-15 controller.c: increase test time for buzzer
    [controller.c]
2020-04-15 Pdiff unit-tested over all cycle More accurate motor_* simulation
    [configuration.h]
2020-04-15 Unit-tested sensors, motor, valve
    [configuration.h]
2020-04-16 Fix motor_release called with duration instead of timestamp
    [configuration.h]
2020-04-16 Fix light_green missing in native
    [simple_indicators.c]
2020-04-16 Fixed sensing for Insufflation+Plateau (Exhalation still broken)
    [controller.c, lowlevel_simulation.c, main.c]
2020-04-16 Fixed sensing so as to loop cycle_respiration
    [controller.c, controller.h]
2020-04-16 Fixed volume and flow into sense_and_compute
    [controller.c, lowlevel_simulation.c]
2020-04-16 Fixed VTe sign for RESP
    [controller.c]
2020-04-16 Add support for cross compile stm32 on windows
2020-04-16 Moved static pattern and data out of send_... to fix a crash on target Added basic unit test to avoid regression Added send_DATA_X for additional Pplat, PEP (only during pauses)
    [main.c]
2020-04-17 Fix build for stm32
    [main.c]
2020-04-17 Continuously send active alarms to the IHM @ 2Hz
2020-04-18 Implemented - sensors - buzzer - lights - pep_valve - bavu motor
    [controller.c, motor.c, pep_valve.c, recovid_revB.h, sensors.c]
2020-04-18 Add led blinking acc. to active alarms
2020-04-18 Disable battery queries until they are implemented
2020-04-18 Added motor_step_times_us table that will be updated after insufflation and passed to motor_move_table before next insufflation
2020-04-18 Moved all calibration constants to configuration.h
    [configuration.h]
2020-04-19 WIP attempt to bring v1 flow fitting n pid to high level not compiled
2020-04-19 Fix build
    [configuration.h]
2020-04-19 configuration.h : Fix compilation (do not define a symbole in header)
    [configuration.h]
2020-04-19 Added motor_pep.c
2020-04-19 add missing motor_pep.c
2020-04-19 Support UART2 and UART4
2020-04-19 lowlevel: motor: fix limit detector
    [motor.c]
2020-04-19 Deug: lowlevel: motor press
2020-04-19 Implement all battery-related alarms
2020-04-19 Debug: motor: on going
2020-04-19 lowlevel: stm32: add delay (agnostic either in a freertos task or not yet)
2020-04-20 Added compute_motor_steps_and_Tinsu_ms based on compute_samples_average_and_latency_us to auto calibrate flow and volume cycle after cycle
    [configuration.h]
2020-04-20 Fix build and warnings
    [controller.c, lowlevel_simulation.c]
2020-04-20 WIP read sensors
2020-04-20 Cleanup motor steps tables spread around
    [configuration.h]
2020-04-20 Disabled regulation_pep for first v2 cycle tests Cleanup TaskAlarm.c and motor_release(...)
2020-04-20 Working Buzzer Lights, Motors, Sensors
    [controller.c, motor_pep.c, recovid_revB.h]
2020-04-20 Try new flow adaptation algorithm on V1.5 RevB
2020-04-20 Ignore cmake files of stm32 build on win32
2020-04-20 Changed motor init sequence.
2020-04-20 Fix motor init sequence (home was not cleared by IT); Modified TaskRespirationCycle to linear implémentation.
    [controller.c, motor.c]
2020-04-21 Add missing function for simulation
    [lowlevel_simulation.c]
2020-04-21 Fix sensors computation of current_pressure/flow/volume WIP correction of readings to avoid drift over time
    [lowlevel_simulation.c, sensors.c]
2020-04-21 Fix time unit error
    [lowlevel_simulation.c, sensors.c]
2020-04-21 UART4 enable => disable UART2 completly
2020-04-21 Output and Motor in parallel
2020-04-21 Fix broken !stm32 build
    [controller.c]
2020-04-21 Only save I2C data and compute outside from interrupt
2020-04-22 First adaptative insulflation : to be fixed based on curves analysis
    [controller.c, lowlevel_simulation.c, motor.c, sensors.c]
2020-04-23 Remove debugging trace
2020-04-23 Enable UART Read
2020-04-23 Fix borken native build by moving sensing.c related unit tests from lowlevel_simulation.c
    [controller.c, lowlevel_simulation.c, main.c]
2020-04-23 Do not build unit tests on stm32
2020-04-23 Ajout des scripts python pour le calcul du fit
2020-04-23 Add acceleration phase within motor_press_constant
    [configuration.h]
2020-04-23 controller : basic working version with no flow plateau
2020-04-23 Add test motor function for checking acceleration phase
2020-04-23 native: fix broken build
    [controller.c]
2020-04-23 Reworked Architecture - Decoupled Controller, Monitoring and Breathing tasks - Cleanup BSP
    [breathing.h, controller.c, controller.h, flash.c, indicators.c, main.c]
2020-04-24 Ignore uart badly formed frames
2020-04-25 Finally a working and clean architecture
    [configuration.h]
2020-04-25 Almost there. Added dbg_print and dbg_printf functions
    [configuration.h]
2020-04-26 Working base (execpt the uart RX mechanism. Need to have a closer look at the RTO feature to trigger the processing of the already received bytes).
2020-04-26 Capteur I2C de débit : Suppression d'envoi de messages inutiles
2020-04-26 Ajout de notes sur SDP610
2020-04-26 Final rework - good starting point
    [breathing.c, breathing.h, common.h, controller.c, controller.h]
2020-04-27 Ajout d'un script de log TSI test Moteur
2020-04-27 Add SensorTest script interpTSIV2
2020-04-27 Adding Sam's flow adaptation into the breathing task
2020-04-28 Fix bug TSI Calibrate
2020-04-28 Improve init motor : if only one switch is On move away from home
2020-04-28 Test motor only
2020-04-28 move motor_press_constant to motor
    Signature changes to return the total motor time (sum of the steps time's)
2020-04-28 motor.c: print steps and Q samples
2020-04-28 motor.c: printing P samples
2020-04-28 Compute and print steps using Christophe methods
2020-04-28 Fix sampling for NPA
    [sensors.c]
2020-04-28 motor: print : each steps
2020-04-28 Move to lowlevel compute motor
    TODO : Beware we wait 200 ms before motor_release
2020-04-28 [uart] update ihm main fct send_and_recv. WiP
2020-04-28 [uart] reinit frame at end of recpt
2020-04-28 [uart] can read on mutliple jobs of the comm task
2020-04-28 uart - fix
2020-04-29 Apply I2C state machine change from Julien
2020-04-29 Add compute motor functions
2020-04-29 Plug compute motor to breathing
2020-04-30 And finally we got the motor working !!!!!!
    (cherry picked from commit 10ff78b8cc08fb7f5ce593f63a429e095501d14c)
2020-04-30 uart - fix
    (cherry picked from commit a03ad85e16f95ea19c58b1d8c9f1fb9a23fc2d03)
    [protocol.c]
2020-04-30 [uart] reinit frame at end of recpt
    (cherry picked from commit 79d4e9f1848b2f4641cfe06585fee0bd8c89a5a5)
2020-04-30 [uart] can read on mutliple jobs of the comm task
    (cherry picked from commit 42a950e9da1d6133f4860320c4939c159be87173)
2020-04-30 Fix release build for simu
    [common.h]
2020-04-30 Enable christophe plateau
2020-04-30 Move to 32bits for Timer acces using DMA
2020-04-30 Allow configurable ratio in case of changing ustepins settings
2020-04-30 Première intégration, manque les fonctions de lecture / écriture sur le bus.
    (cherry picked from commit 336d177db0dba4d1655a60cc69c7f171fb8e67f3)
2020-04-30 Debug divers. Découpage de la lecture du BMP280 en deux phases.
    (cherry picked from commit cef4f8b30d7a6d4b89829e8f17752c9c3ee08135)
2020-04-30 compute_motor.c: fix warnings unsigned vs signed
    [compute_motor.c]
2020-05-01 Fix compilation for simu
    [lowlevel_simulation.c, main.c]
2020-05-01 I2C sensors : get full speed sampling on every sensor
2020-05-01 sensors.c: homogeneisation des retours des read_Capteurs
2020-05-01 sensors.c: homogeneisation des retours des read_Capteurs
    (cherry picked from commit 1ad8b888a9873a9ee61def9843330c1b5765b028)
2020-05-01 Add Pplat sampling for a rolling average during plateau phase
2020-05-01 Add Pcret sampling to get the maxi Paw during Insulflation+Plateau
2020-05-01 fixup! Allow configurable ratio in case of changing ustepins settings
2020-05-05 Fixing UART
2020-05-05 Fixed UART framing error when RPi boots Grouped IRQ priorities defs in bsp header (recovid_revB.h) Fixed sensors IRQ loop unexpected exit on error
    [config.h, controller.c, hmi.c, protocol.c, recovid_revB.h, recovid_revB_hal_msp.c]
2020-05-05 Better support for MOTOR settings differents
    Modify simu Cmakelist to expose platfrom_defs.h to top level
    Add few define in platform_defs to fix compile
    [compute_motor.h, platform_defs.h]
2020-05-05 Update compute_motor.h
    Fix include
    [compute_motor.h]
2020-05-05 New fix for UART. Ignore framing/overrun/noise errors Added Texp in breathing. Still need to find out what messages to send while in Tpins et Texp
    [breathing.c, controller.c, hmi.c, recovid_revB.h, uart.c]
2020-05-07 Added init function to modules to allow for module specific initialization Added soft timer to sample Paw and Pdiff during breathing cycle. Increased FreeRTOS Heap and tasks stack sizes
2020-05-08 Fix motor_pep is_moving() Fix motor homing pb. (removed software debouncing and increased IRQ priority => we get all switches bounces, but we won't miss them. Next hardware should add RC debouncing t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
    [adaptation.c, adaptation.h, breathing.c, breathing.h, controller.c, controller.h, hmi.c]
2020-07-01 Avoid 32bits overflow by using pow2 modulo
    [protocol.c]
2020-07-01 Add 3 digits to Volume and Debit for data analysis and error fitting
    [protocol.c]
2020-07-01 Add some data in communication frames
    * State + slm in DATA / DATAX
    * msec in RESP
2020-07-02 Add Patmo and Temp in RESP frame
2020-07-02 Fix operator priority and variable name
    [protocol.c]
